JKM8932/y1lunarrover/README.md

# y1lunarrover

This serves as a repository for Group 29 of the 1stYear 2026, dedicated to the Lunar Rover project. Project ideas, preliminary circuit diagrams and software programmes will be documented here.
