JKM8932/y1lunarrover/Infrared/TransimpedanceAmplifierLTSPICE.md

Screenshot 2026-05-26 at 1 48 17 PM
