JKM8932/y1lunarrover/Age(UART)/OutputOscilloscope.md

da442616-0aa2-4d29-abf5-146e816dc095
