JKM8932/y1lunarrover/Age(UART)/OutputLTSPICE.md

Screenshot 2026-05-26 at 1 22 15 PM
