JKM8932/y1lunarrover/Age(UART)/FullAgeDetectorLTSPICE.md

Screenshot 2026-05-26 at 1 16 26 PM
