JKM8932/y1lunarrover/Age(UART)/Receiver&AmplifierLTSPICE.md

Screenshot 2026-05-19 at 5 45 23 PM
