JKM8932/y1lunarrover/Infrared/Notes.md

We observed that the infrared pulses came from the following bulbs on the back of the PCB in the rock:
Screenshot 2026-05-19 at 3 54 23 PM
oscilloscopeir

  The infrared pulses that these bulbs emit travel through a tiny hole made on the outer surface of the rock, which is where we are supposed to place the infrared detector above of:  
Screenshot 2026-05-19 at 3 54 14 PM

  The magnitude of the pulses detected at the hole were really low, around 100mV~. Highly likely that we will use a Schmitt Trigger or an amplifier to largen the pulse amplitude. Also attempted at making an algorithm to identify the infrared wavelength (312 or 547), though it was highly inaccurate (refer to initialtestcode.ino). The premise is that we would calculate the average number of pulses in a time window to determine roughly which of 312 or 547 the pulses lean towards.
