JKM8932/y1lunarrover/image.png

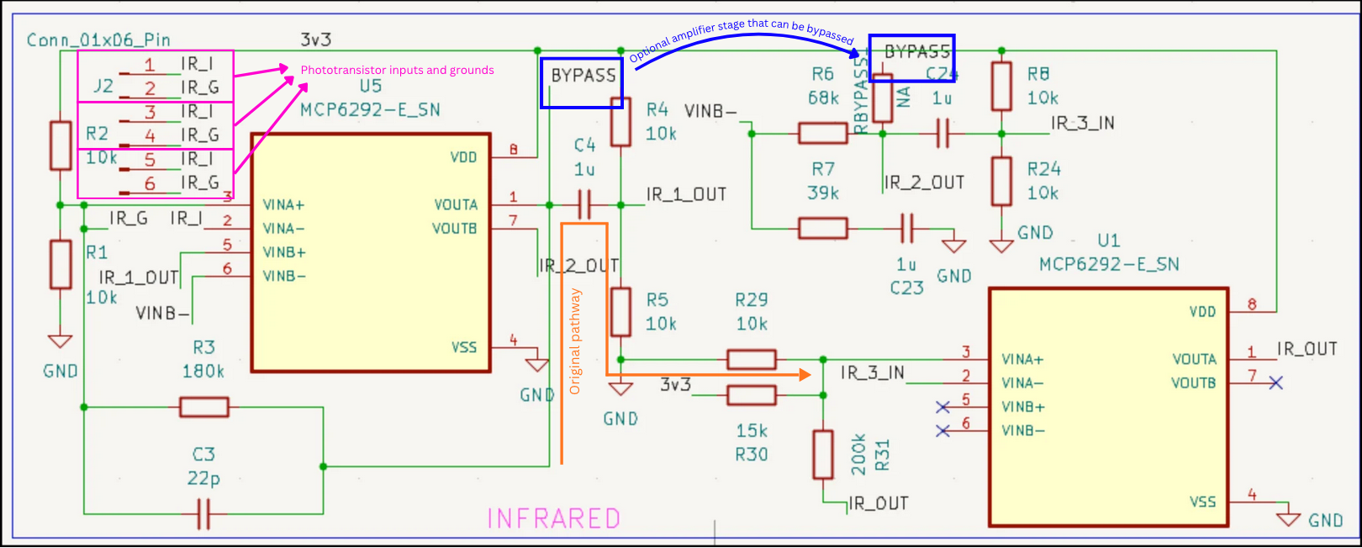
image.png
