JKM8932/y1lunarrover/Infrared/FinalCircuitIR.png

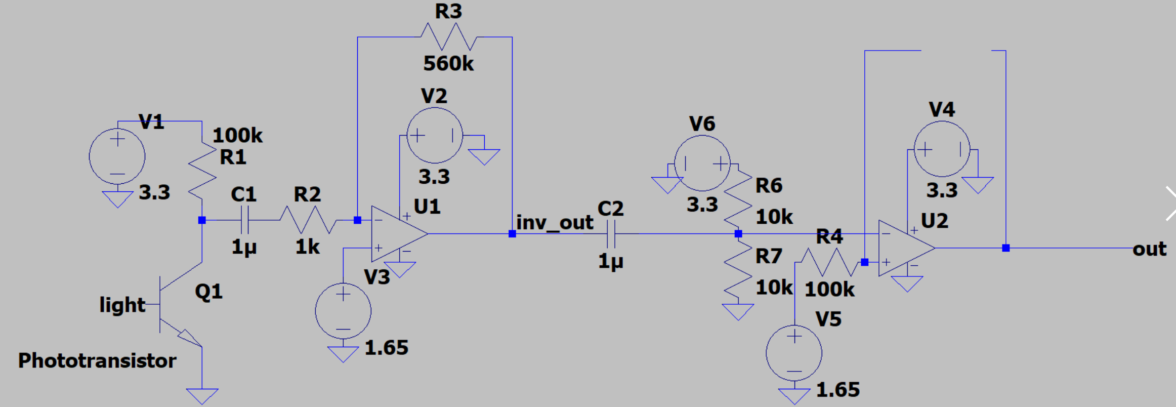
Infrared/FinalCircuitIR.png
