JKM8932/y1lunarrover/Infrared/FullCircuit(TIA)+OptionalStage(RED).jpg

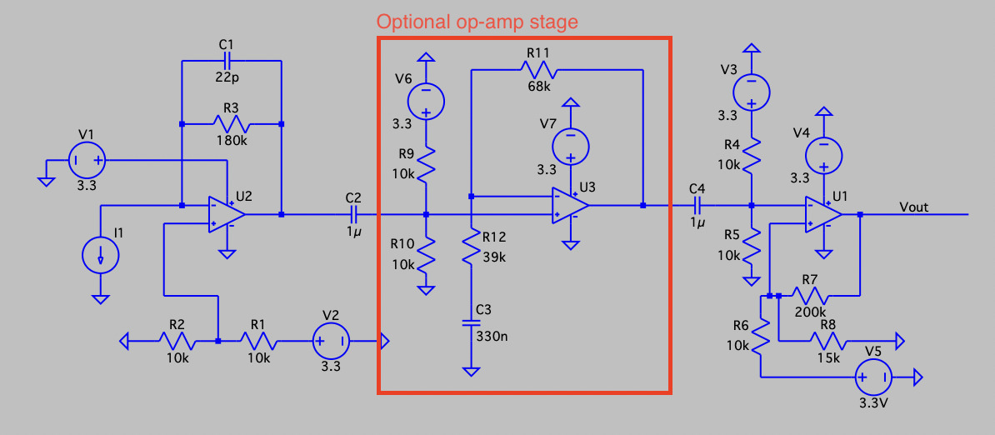
Infrared/FullCircuit(TIA)+OptionalStage(RED).jpg
