JKM8932/y1lunarrover/Magnetic/finalschematic.jpg

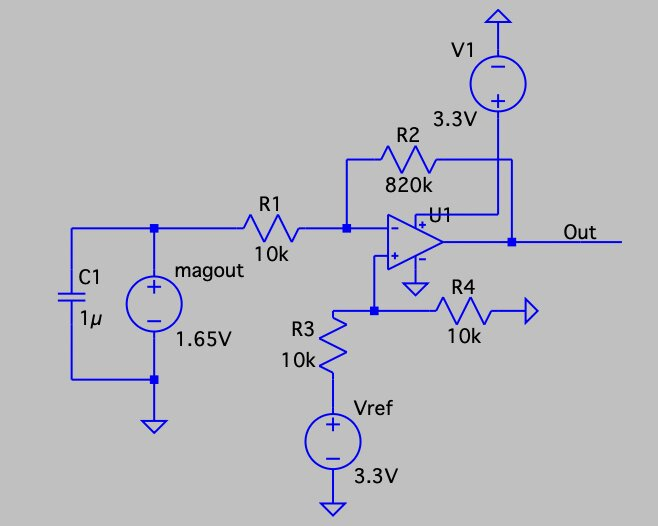
Magnetic/finalschematic.jpg
