JKM8932/y1lunarrover/PCBDesign/fullpcb.png

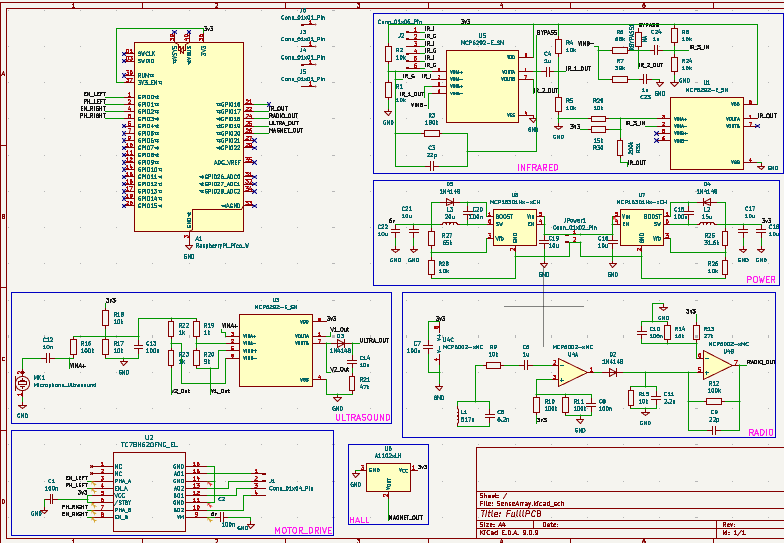
PCBDesign/fullpcb.png
