JKM8932/y1lunarrover/PCBDesign/magneticpcb.png

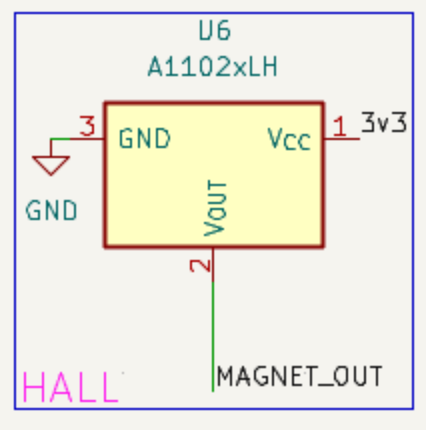
PCBDesign/magneticpcb.png
