JKM8932/y1lunarrover/PCBDesign/motordrivepcb.png

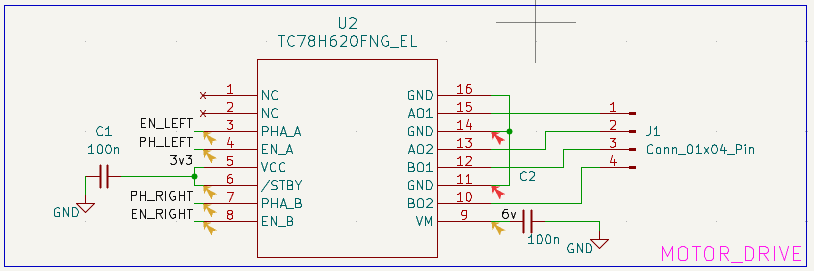
PCBDesign/motordrivepcb.png
