JKM8932/y1lunarrover/PCBDesign/picolayoutpcb.png

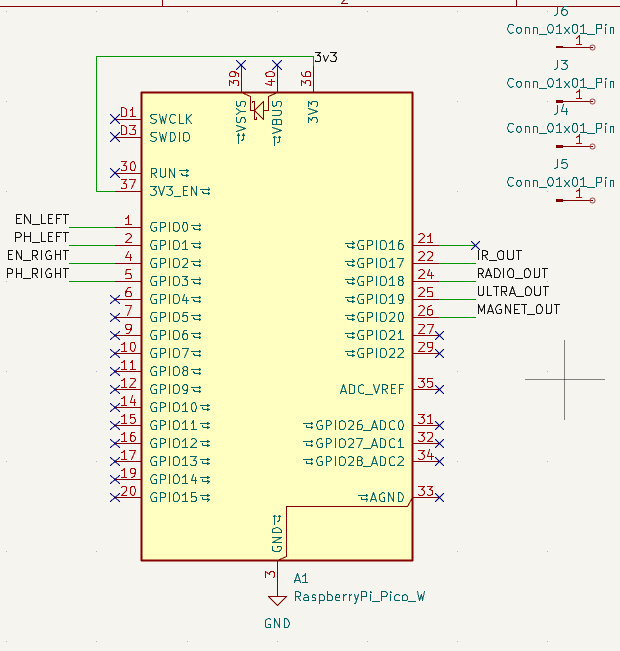
PCBDesign/picolayoutpcb.png
