JKM8932/y1lunarrover/PCBDesign/powerforpcb.png

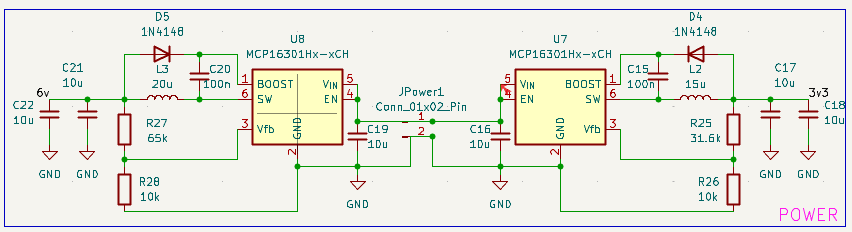
PCBDesign/powerforpcb.png
