JKM8932/y1lunarrover/PCBDesign/radiopcb.png

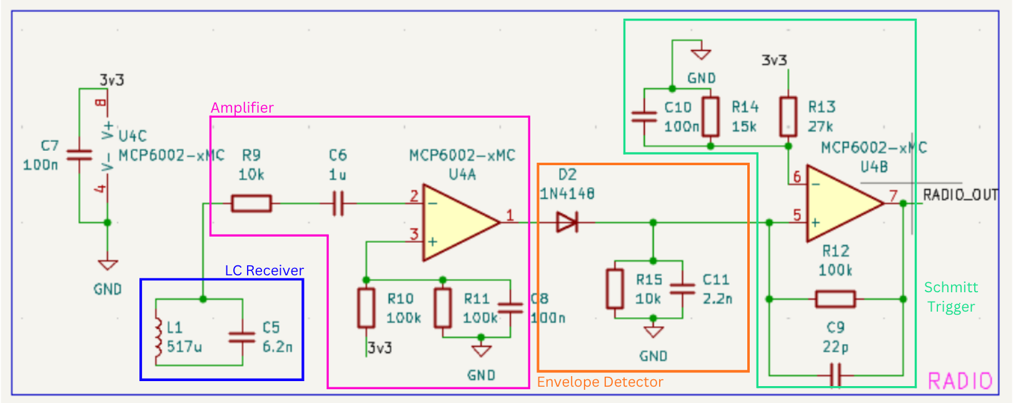
PCBDesign/radiopcb.png
