JKM8932/y1lunarrover/PCBDesign/ultrasoundpcb.png

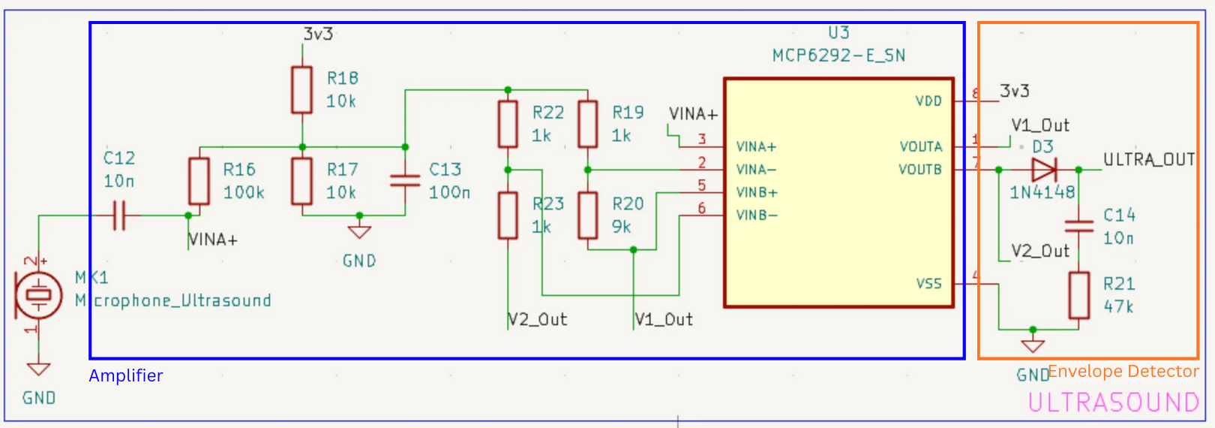
PCBDesign/ultrasoundpcb.png
