JKM8932/y1lunarrover/Ultrasound/Ultrasound_Schematic.jpg

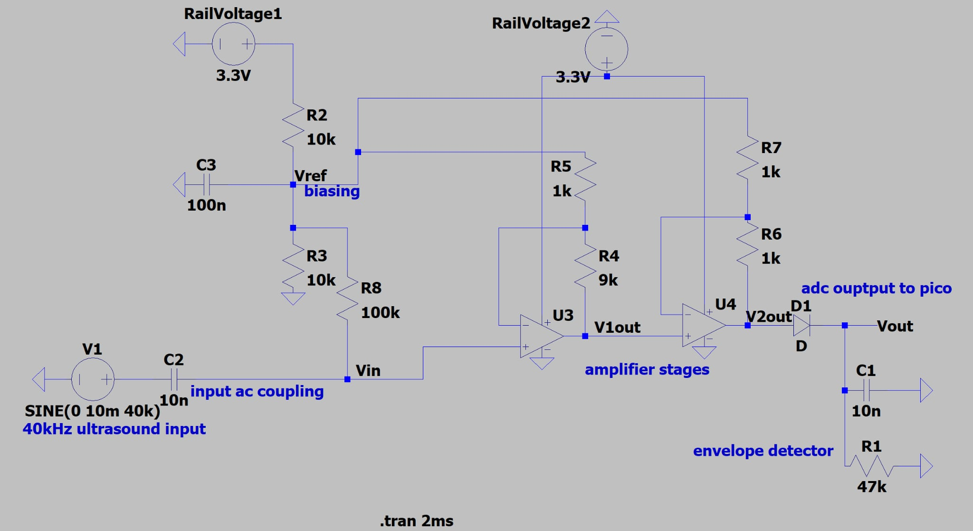
Ultrasound/Ultrasound_Schematic.jpg
