JKM8932/y1lunarrover/Spec.ods

Is it possible to find the characteristics of all the rocks?
Is the design cost and weight effective?
Is the rover manoeuvrable enough to negotiate the environment?
Is the construction robust and reliable?
Is the remote control interface logical and easy to use?
 | Spec Code | Category | Secondary Category | Priority | Description | Justification | Testing (Minimum) | Testing (Ideal) | Quantitative/ Qualitative?
 | C1 | CHARACTERISTIC |  | HIGH | The Rover must be capable of detecting and processing radio waves of 89kHz carrier frequency through a coil, to decipher the age of the Rock. | As instructed, each Rock emits age data through a radio emitter. | Detect radio signals of 89kHz carrier frequency. | Process radio frequency from Test Rock to provide an output of Age. | Quantitative
 | C2 | CHARACTERISTIC |  | HIGH | The Rover must be able to detect and differentiate between 2 infrared signals with frequencies of 312 and 547 s^-1, to help classify the Rock. | As instructed, each Rock emits characteristic data through a combination of infrared waves, ultrasound waves and a magnetic field. | Detect infrared signals from at least 3cm away from the sensor. | Differentiate between 312 and 547 s^-1 infrared waves emitted from a Test Rock and output a signal dictating the frequency. | Quantitative
 | C3 | CHARACTERISTIC |  | HIGH | The Rover must have the ability to receive a 40kHz ultrasound signal from a Rock, and differentiate with certainty between the presence of the signal and its absence. | As instructed, each Rock emits characteristic data through a combination of infrared waves, ultrasound waves and a magnetic field. | Detect ultrasound signals from at least 3cm away from the sensor. | Detect ultrasound signals and output a signal of 1 only when the ultrasound wave has a frequency of 40kHz. | Quantitative
 | C4 | CHARACTERISTIC |  | MEDIUM | The Rover must possess a method to observe the polarity of a magnetic field beneath it, and hence return whether the magnetic field of the magnetic field is considered down or up. | As instructed, each Rock emits characteristic data through a combination of infrared waves, ultrasound waves and a magnetic field. | Detect the presence of a magnetic field correctly. | Detect a magnetic field from the Test Rock and output if the field is considered ‘up’ or ‘down’. | Quantitative
 | C5 | CHARACTERISTIC |  | MEDIUM | The Rover must utilise the characteristic data from C1 to C4 to provide a collective, simple output that gives a rock classification and age cleanly. | A simpler output improves the speed of data collection, which can minimise the time it takes to classify each Rock, especially during the demo. | Classification data of at least infrared and ultrasound is combined to provide a single classification. | All data is combined to provide an age and classification clearly for each rock measured, where that is the main/ only output. | Qualitative
 | CE6 | COST EFFECTIVE |  | MEDIUM | Wherever possible, use materials given in the lab-in-a-box and EEEBug Expansion kit by the robotics lab that do not count towards the budget, without compromising function. | These materials do not count towards our spending budget, so using these will minimise the cost of the Rover effectively. | Less than £60 of the budget is spent on the Rover. | Less than #30 of the budgets is spent on the Rover, with at least one useful component on the Rover being from the EEEBug. | Quantitative
 | CE7 | COST EFFECTIVE | WEIGHT EFFECTIVE | MEDIUM | Ensure that sensors used can perform the minimum function required, and nothing more. | There are many sensors available on the market, that can have a lot of capability for a variety of purposes, such as extreme temperature resistance or multiple modes of function. To minimise cost and also weight, we should use sensors that provide the bare minimum for our purposes and keep things simple and effective. | Each sensor is capable of performing its task. | Each sensor is capable of performing its task without any extra functionality according to the datasheet.
 | W8 | WEIGHT EFFECTIVE |  | CRITICAL | The Rover must not weigh more than 750g and beyond this must minimise its weight as much as possible, without compromising function. | As instructed, and also a lighter rover allows it to drive faster across terrain, enabling us to collect data faster. | The Rover must weigh less than 750g as according to the weight sensitive area on the testing zone. | The Rover should weigh less than 500g as according to the weight sensitive zone. | Quantitative
 | R9 | ROBUST/ RELIABLE | MANOUVERABLE | HIGH | The Rover must drive on at least 4 wheels or points of contact with the ground. | This provides an even, stable base to work with, allowing the angles and positioning of our sensors to remain constant. This also allows the Rover to travel faster without cause for error, while accounting for if we do not want to use more than 2 wheels. | The Rover must have at least 4 points of contact with the ground. | The Rover must have at least 4 points of contact with the ground where its weight is distributed evenly. | Quantitative
 | R10 | ROBUST/ RELIABLE |  | MEDIUM | The Rover must provide a flat base for the sensors, MCUs and other components to sit, parallel to the ground. | This provides an even, stable base to work with, allowing the angles and positioning of our sensors to remain constant. It reduces the chances of components falling off, and makes the components easier to access. | A spirit gauge shows the MCU and sensor base to be flat/ parallel with the ground. | A spirit gauge shows the MCU and sensor base to be flat/ parallel with the ground. | Qualitative
 | M11 | MANOUVERABLE |  | MEDIUM | The Rover must have mechanisms or hardware in place to increase its speed beyond the base EEEBug. | This lets us provide a faster Rover that can roam the terrain easily, so we can scan more rocks in the same amount of time. | The Rover must travel faster than the EEEBug in straight line speed. | The Rover must be able to travel at 1m/s in straight line speed. | Quantitative
 | M12 | MANOUVERABLE | CONTROL INTERFACE | HIGH | The Driver Control for the Rover must be intuitive and make logical sense for someone controlling it. | Minimises the time required to practice driving the Rover and lessens the learning curve for effectively controlling the Rover. | Anyone in the team who tries learning to control the Rover is able to do so quickly, in under 5 minutes to reach high confidence. | Anyone who tries learning to control the Rover is able to do so quickly, in under 5 minutes to reach high confidence. | Qualitative
 | M13 | MANOUVERABLE | CONTROL INTERFACE | LOW | The Driver Control for the Rover must allow for the speed of the Rover to be adjusted easily and instantaneously while controlling the Rover. | Increases the control of the driver over the Rover, to allow for finer adjustment of the Rover. | The speed of the Rover can be adjusted by the user. | The speed of the Rover can be adjusted by the user while they manuever the Rover. | Quantitative
 | R14 | ROBUST/ RELIABLE | MANOUVERABLE | HIGH | The wheels of the Rover must avoid cantilever, which means it must be supported from both sides. | Increases stability of the Rover, and hence the speed of the Rover as all loads are distributed evenly. This increases robustness and general build quality. | The Rover’s wheels are supported physically from both sides of the wheel. | The Rover’s wheels are supported physically from both sides of the wheel. | Qualitative
 | R15 | ROBUST/ RELIABLE |  | CRITICAL | The Rover must be sturdy and strong enough to not suffer any damage or major wear and tear from any kind of collision between the robot and a wall. | As Instructed. Accidental collisions with the walls, rocks, and potentially if other rovers run into us are quite likely to happen. In order to reduce the impact these events have on the progress of the data collection, the Rover must be able to withstand these. | The Rover will remain unharmed when it collides into a wall at full speed. | The Rover will remain unharmed when it collides into a wall at full speed 10 times in a row. | Qualitative
 | R16 | ROBUST/ RELIABLE | MANOUVERABLE | CRITICAL | The Rover must be reliable in its control, which means it will drive predictably and be responsive to Driver Control inputs. | In a high stress environment such as in a demo or on another planet, a reliable Driver Control is valuable as the user can take responsible and logical steps to manouver the Rover however they like. | The Rover has no unusual behaviour in control, and has a response time to input of 0.5 seconds or less. | The Rover has no unusual behaviour in control, and has a response time to input of 0.1 seconds or less. | Qualitative
 | CI17 | CONTROL INTERFACE |  | HIGH | The User Interface must be as simple and easy to understand as possible, so at a base level it will only show the key information required to operate the vehicle and nothing more. | Reducing excess information on the User Interface allows the user controlling the Rover to not get distracted and keep performing their task. | Anyone in the team who tries learning to control the Rover is able to do so quickly, in under 5 minutes to reach high confidence. | Anyone who tries learning to control the Rover is able to do so quickly, in under 5 minutes to reach high confidence. | Qualitative
 | CI18 | CONTROL INTERFACE | CHARACTERISTIC | HIGH | The User Interface, while following CI17 especially, must have methods to display more details and information if requested by the user. | The user may require certain pieces of information, though not always. Being able to choose only the data that is needed in the moment to be shown is most efficient and clear to the user. | The User Interface should have a method to display at least 1 piece of extra information at the user’s discretion. | The User Interface should have a method to display at least 3 pieces of extra information at the user’s discretion. | Qualitative
 | CI19 | CONTROL INTERFACE |  | MEDIUM | The User Interface has to make use of visuals to signal to the user various information and instructions, rather than just using text details. | A visual demonstration and imagery can be a lot quicker and easier for people to understand, especially users who may be in a rush and a high pressure environment when navigating the Rover, | Anyone in the team who tries learning to control the Rover is able to do so quickly, in under 5 minutes to reach high confidence. | Anyone who tries learning to control the Rover is able to do so quickly, in under 5 minutes to reach high confidence. | Qualitative
 | CI20 | CONTROL INTERFACE |  | MEDIUM | The Driver Controls must be simple and straightforward, such that anyone can pick up the controller and use it. | If anyone is able to control the Rover easily, then there is no reliance on a dedicated driver, improving team fluidity and allowing for contingencies. | Anyone in the team who tries learning to control the Rover is able to do so quickly, in under 5 minutes to reach high confidence. | Anyone who tries learning to control the Rover is able to do so quickly, in under 5 minutes to reach high confidence. | Qualitative
 | CI21 | CONTROL INTERFACE | MANOUVERABLE | LOW | The Rover may have the capability of collision detection, where it will sense if it is about to collide with an object and aid the driver of the Rover quickly and easily. | Improves efficiency of the Rover in terms of its movement, while reducing the risk of on board components getting damaged or jolted by such collisions. | The Rover can detect collisions and warn the user. | The Rover can detect collisions and automatically adjust its route to avoid the obstacle. | Qualitative
 | CI22 | CONTROL INTERFACE | CHARACTERISTIC | MEDIUM | The characteristics of each rock could be displayed in a tabular form on the User Interface, such that we can gather the data of multiple rocks in an easily accessible form. | When gathering the data, especially to use on an online form, it can be useful to have all the data in one place. This lets us be more analytical of the data too. | At least 1 row of a table with the required information is displayed on the User Interface. | As many rows of a table as there are rocks measured with the required information is generated and displayed on the User Interface. | Qualitative
