JKM8932/y1lunarrover/FullPCB/MCP6292-E_SN.step

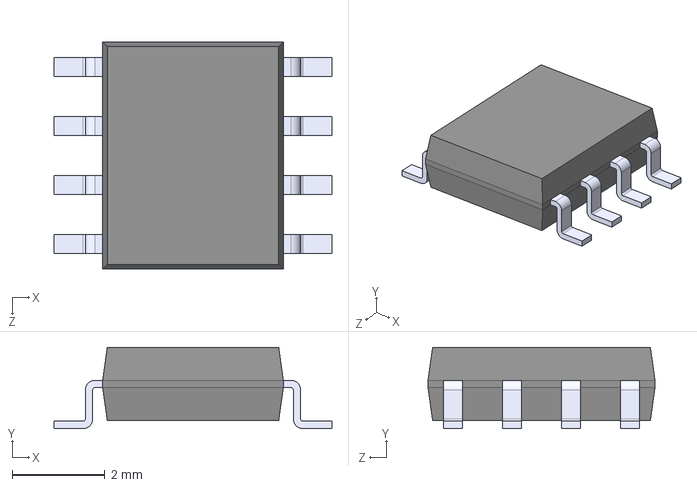
[picture p13: CAD file, 2026-06-11]
FullPCB/MCP6292-E_SN.step
6.00 x 1.75 x 4.90 mm
