JKM8932/y1lunarrover/Summer-Chassis-1.step

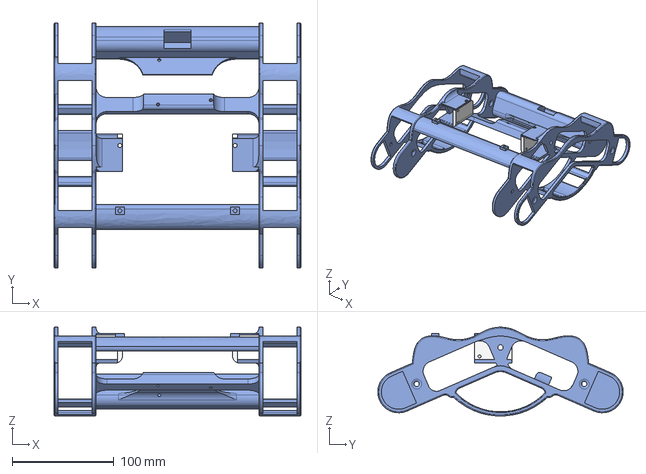
[picture p14: CAD file, 2026-06-11]
Summer-Chassis-1.step
243.1 x 241.4 x 87.4 mm
