JKM8932/y1lunarrover/final_cut.dxf

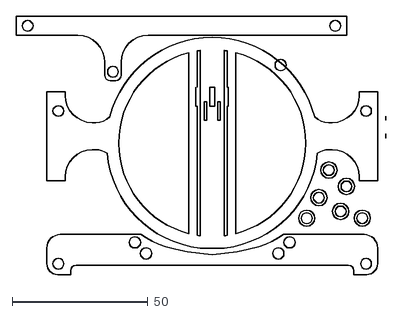
[picture p15: CAD file, 2026-06-11]
final_cut.dxf
136.4 x 95.3
