JKM8932/y1lunarrover/(list of files, cad)

Other CAD files:
Summer-Chassis-1.3mf
