JKM8932/y1lunarrover/SenseArray/SenseArray.kicad_pcb

## KiCad design SenseArray/SenseArray.kicad_pcb (2026-06-11)

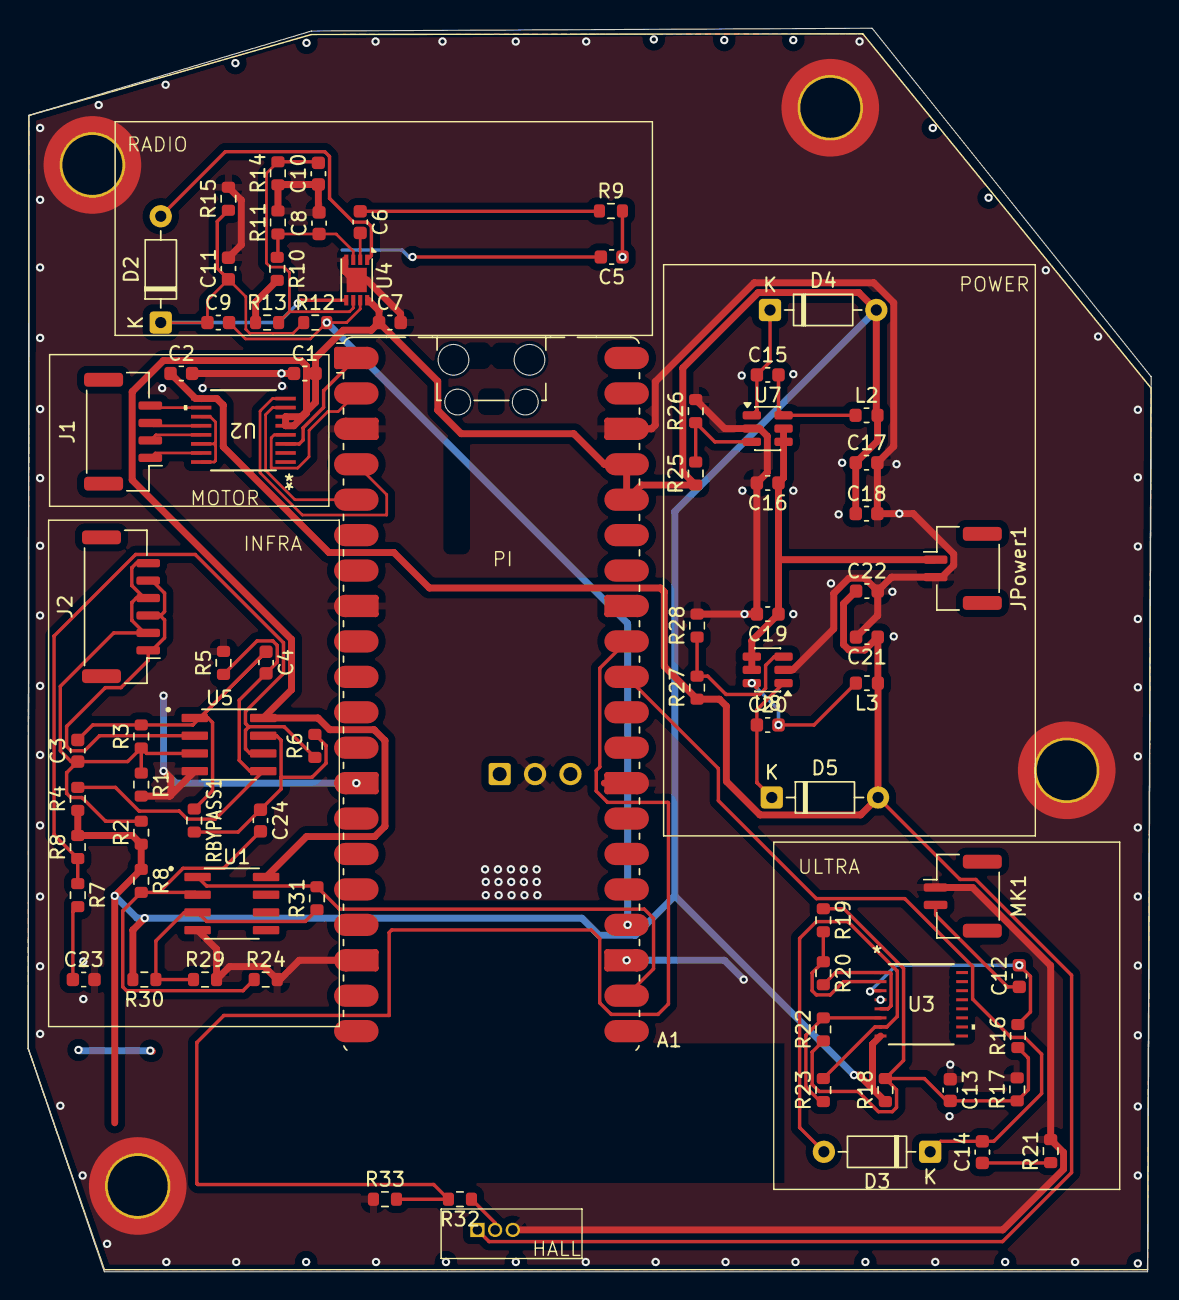
[picture p16: board SenseArray.kicad_pcb from above]

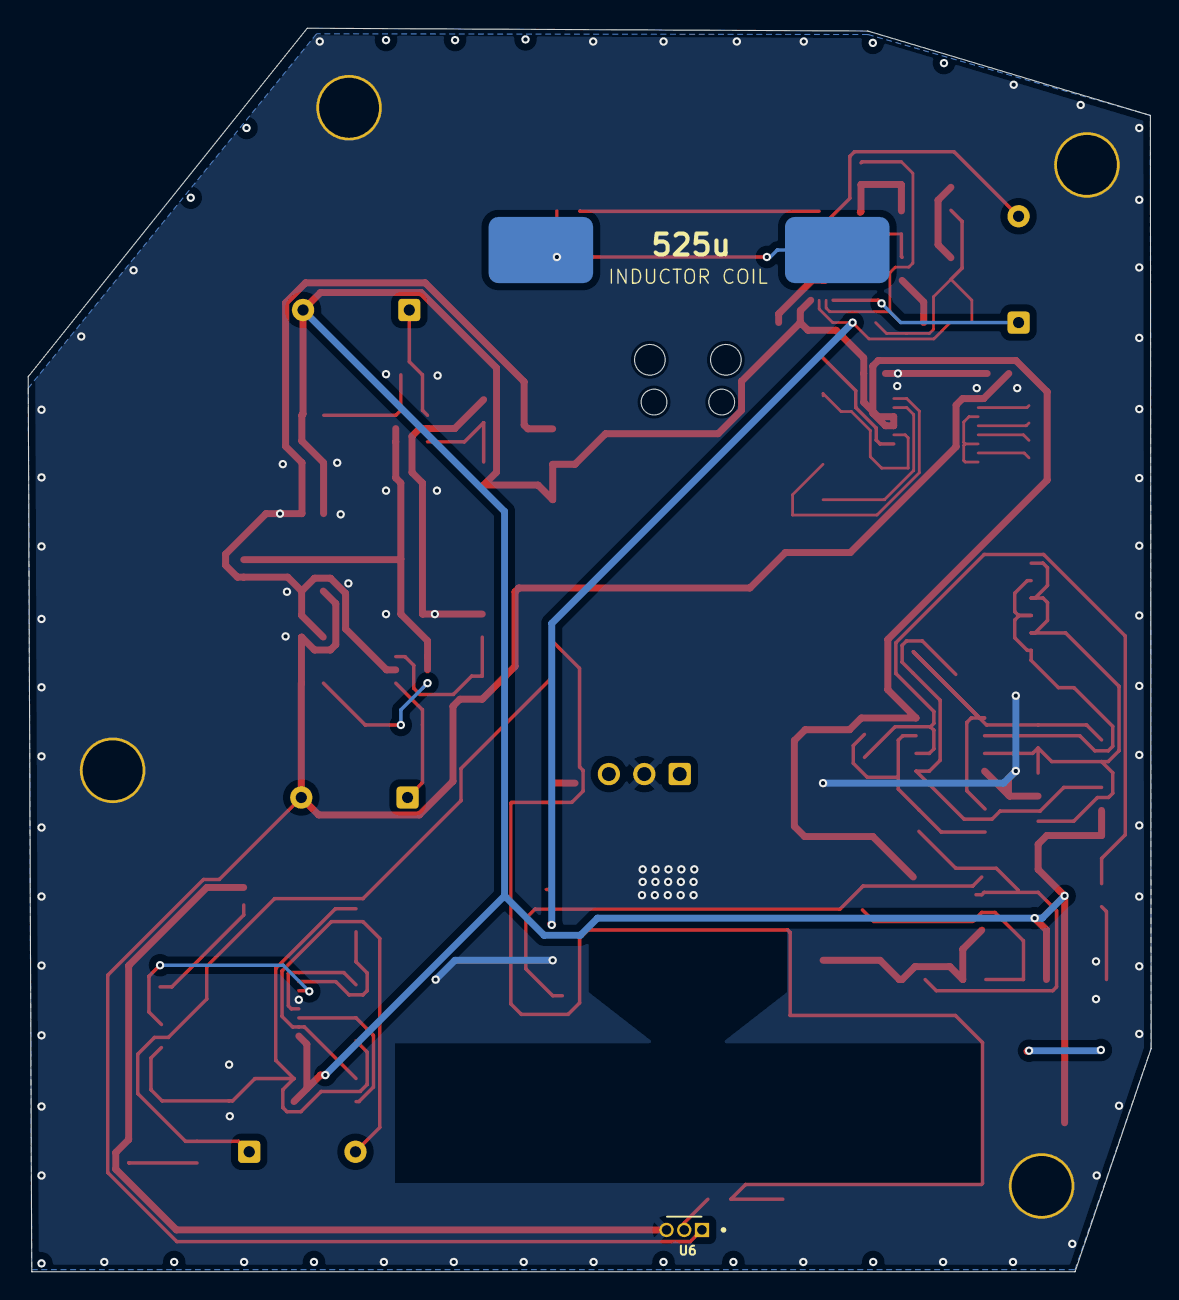
[picture p17: board SenseArray.kicad_pcb from below]

Board: 2 copper layers, 80.5 x 89.1 mm, 83 parts (2 on the bottom side), 48 nets.

Parts:
A1: RaspberryPi_Pico_W; RaspberryPi_Pico_W_SMD_HandSolder
C1, C2, C7, C8, C10, C13, C15, C20: 100n; C_0603_1608Metric
C3, C9: 22p; C_0603_1608Metric
C4, C6, C23, C24: 1u; C_0603_1608Metric
C5: 6.2n; C_0603_1608Metric
C11: 2.2n; C_0603_1608Metric
C12, C14: 10n; C_0603_1608Metric
C16, C17, C18, C19, C21, C22: 10u; C_0603_1608Metric
D2, D3, D4, D5: 1N4148; D_DO-35_SOD27_P7.62mm_Horizontal
J1: Conn_01x04_Pin; JST_GH_BM04B-GHS-TBT_1x04-1MP_P1.25mm_Vertical
J2: Conn_01x06_Pin; JST_GH_BM06B-GHS-TBT_1x06-1MP_P1.25mm_Vertical
J3, J4, J5, J6: Conn_01x01_Pin; MountingHole_4.3mm_M4_ISO14580_Pad_TopOnly
JPower1: Conn_01x02_Pin; JST_GH_BM02B-GHS-TBT_1x02-1MP_P1.25mm_Vertical
L1: 517u; Untitled
L2: 15u; L_0603_1608Metric
L3: 20u; L_0603_1608Metric
MK1: Microphone_Ultrasound; JST_GH_BM02B-GHS-TBT_1x02-1MP_P1.25mm_Vertical
R1, R2, R4, R5, R8#2, R9, R15, R17, R18, R24, R26, R28, R29, R32, R33: 10k; R_0603_1608Metric
R3: 180k; R_0603_1608Metric
R6: 68k; R_0603_1608Metric
R7: 39k; R_0603_1608Metric
R8, R14, R30: 15k; R_0603_1608Metric
R10, R11, R12, R16: 100k; R_0603_1608Metric
R13: 27k; R_0603_1608Metric
R19, R22, R23: 1k; R_0603_1608Metric
R20: 9k; R_0603_1608Metric
R21: 47k; R_0603_1608Metric
R25: 31.6k; R_0603_1608Metric
R27: 65k; R_0603_1608Metric
R31: 200k; R_0603_1608Metric
RBYPASS1: NA; R_0603_1608Metric
U1, U5: MCP6292-E_SN; SOIC127P600X175-8N
U2: TC78H620FNG_EL; SSOP16-P-225-0p65B_TOS-M
U3: MCP6292-E_SN; SSOP16-P-225-0p65B_TOS-L
U4: MCP6002-xMC; DFN-8-1EP_3x2mm_P0.5mm_EP1.75x1.45mm
U6: A1102xLH; XDCR_SS495A
U7, U8: MCP16301Hx-xCH; SOT-23-6

Connections:
/3v3: A1.36 (3V3), A1.37 (3V3_EN), C1.2, C7.1, C17.1, C18.1, D4.2 (A), L2.2, R2.1, R4.1, R8.2, R8#2.1, R10.2, R13.1, R18.1, R25.1, R30.2, U1.8 (VDD), U2.5 (VCC), U2.6 (/STBY), U3.8 (VDD), U4.8 (V+), U5.8 (VDD)
/6v: C2.1, C21.1, C22.1, D5.2 (A), L3.1, R27.1, U2.9 (VM), U6.1 (V_{CC})
/BYPASS: C3.2, C4.1, R3.2, RBYPASS1.1, U5.1 (VOUTA)
/EN_LEFT: A1.1 (GPIO0), U2.3 (PHA_A)
/EN_RIGHT: A1.4 (GPIO2), U2.8 (EN_B)
/IR_1_OUT: C4.2, R4.2, R5.1, U5.5 (VINB+)
/IR_2_OUT: C24.1, R6.2, RBYPASS1.2, U5.7 (VOUTB)
/IR_3_IN: C24.2, R8#2.2, R24.1, U1.2 (VINA-)
/IR_G: C3.1, J2.2, J2.4, J2.6, R1.1, R2.2, R3.1, U5.3 (VINA+)
/IR_I: J2.1, J2.3, J2.5, U5.2 (VINA-)
/IR_OUT: A1.22 (GPIO17), R31.2, U1.1 (VOUTA)
/MAGNET_OUT: A1.32 (GPIO27_ADC1), R32.2, R33.2
/PH_LEFT: A1.2 (GPIO1), U2.4 (EN_A)
/PH_RIGHT: A1.5 (GPIO3), U2.7 (PHA_B)
/RADIO_OUT: A1.24 (GPIO18), C9.2, R12.2, U4.7
/ULTRA_OUT: A1.31 (GPIO26_ADC0), C14.2, D3.1 (K)
/V1_Out: R20.2, U3.1 (VOUTA), U3.5 (VINB+)
/V2_Out: D3.2 (A), R23.2, U3.7 (VOUTB)
/VINA+: C12.2, R16.2, U3.3 (VINA+)
/VINB-: R6.1, R7.1, R8.1, U5.6 (VINB-)
GND: A1.3 (GND), A1.8 (GND), A1.13 (GND), A1.18 (GND), A1.23 (GND), A1.28 (GND), A1.38 (GND), A1.D2 (GND), C1.1, C2.2, C7.2, C8.2, C10.1, C11.2, C13.1, C16.2, C17.2, C18.2, C19.2, C21.2, C22.2, C23.2, J3.1, J4.1, J5.1, J6.1, JPower1.2, MK1.1 (-), R1.2, R5.2, R11.2, R14.1, R15.2, R17.2, R21.2, R24.2, R26.2, R28.2, R29.2, R33.1, U1.4 (VSS), U3.4 (VSS), U4.4 (V-), U4.9 (V-), U5.4 (VSS), U6.3 (GND), U7.2 (GND), U8.2 (GND)
unnamed: C5.1, R9.2
unnamed: C6.1, R9.1
unnamed: C13.2, R16.1, R17.1, R18.2, R19.1, R22.1
unnamed: C14.1, R21.1
unnamed: C23.1, R7.2
unnamed: D2.2 (A), U4.1
unnamed: C9.1, C11.1, D2.1 (K), R12.1, R15.1, U4.5 (+)
unnamed: C15.1, D4.1 (K), U7.1 (BOOST)
unnamed: C20.1, D5.1 (K), U8.1 (BOOST)
unnamed: J1.1, U2.15 (AO1)
unnamed: J1.2, U2.13 (AO2)
unnamed: J1.3, U2.12 (BO1)
unnamed: J1.4, U2.10 (BO2)
unnamed: C16.1, C19.1, JPower1.1, U7.4 (EN), U7.5 (V_{IN}), U8.4 (EN), U8.5 (V_{IN})
unnamed: C12.1, MK1.2 (+)
unnamed: R29.1, R30.1, R31.1, U1.3 (VINA+)
unnamed: U2.11 (GND), U2.14 (GND), U2.16 (GND)
unnamed: R19.2, R20.1, U3.2 (VINA-)
unnamed: R22.2, R23.1, U3.6 (VINB-)
unnamed: C8.1, R10.1, R11.1, U4.3 (+)
unnamed: C6.2, U4.2 (-)
unnamed: C10.2, R13.2, R14.2, U4.6 (-)
unnamed: R32.1, U6.2 (V_{OUT})
unnamed: C15.2, L2.1, U7.6 (SW)
unnamed: R25.2, R26.1, U7.3 (Vfb)
unnamed: C20.2, L3.2, U8.6 (SW)
unnamed: R27.2, R28.1, U8.3 (Vfb)
