JKM8932/y1lunarrover/(commit log)

2026-06-01 Implement ADC reading and direction detection
    This program reads ADC values from a sensor, applies a moving average filter to smooth out readings, and determines the direction based on deviations from a calibrated baseline.
2026-06-04 Refactor ADC handling and calibration logic
    Updated ADC filter size and threshold values for improved sensitivity. Refactored smoothing function and calibration process for better performance.
2026-06-05 Add motor control implementation with UDP support
2026-06-07 Rename Screenshot 2026-06-07 at 22-39-06 Inbox - Mak Justin K - Outlook.png to PCBDesign/magneticpcb.png
2026-06-08 Add motor control test for Pico W
2026-06-08 Update motor pin definitions
2026-06-09 Created updated_motor_control.c
    Rewrote code so that it can be integrated into the main programme, and added gears to change the speed.
2026-06-10 Add motor control testing file
2026-06-11 Move motor_control_testing.c to Chassis directory
2026-06-11 Move motor_control_testing.c to Drive directory
2026-06-11 Rename Screenshot 2026-06-11 at 1.25.02 PM.jpg to Magnetic/FullCircuit(Diffamplifier).jpg
2026-06-11 Rename Screenshot 2026-06-11 at 13-31-39 Optional amplifier stage that can be bypassed when not needed - Presentation.png to PCBDesign/infraredpcb.png
2026-06-11 Rename Screenshot 2026-06-11 at 13-53-45 Optional amplifier stage that can be bypassed when not needed - Presentation.png to PCBDesign/radiopcb.png
2026-06-11 Rename Screenshot 2026-06-11 at 13-54-02 Optional amplifier stage that can be bypassed when not needed - Presentation.png to PCBDesign/ultrasoundpcb.png
2026-06-12 Rename Screenshot 2026-06-12 at 6.26.37 PM.jpg to Magnetic/finalschematic.jpg
2026-06-15 Rename Screenshot 2026-06-15 at 12.26.03 PM.jpg to Magnetic/finalschematic.jpg
2026-06-15 Final Schematic
